aaroexxt/TeensyESC/Pictures/crystals.png

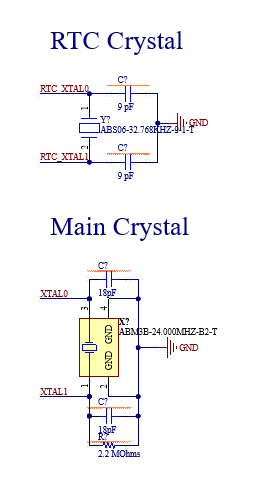
Pictures/crystals.png
