aaroexxt/TeensyESC/Pictures/extio.png

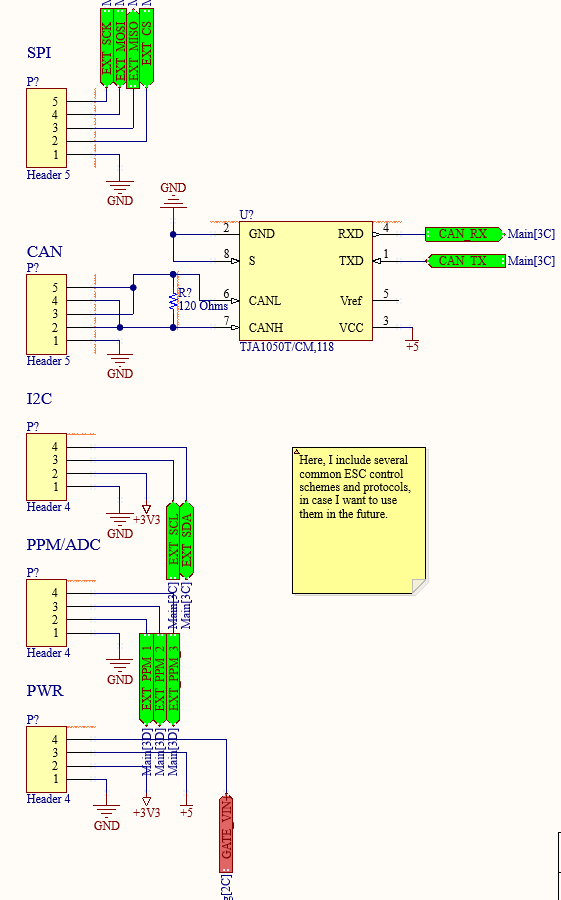
Pictures/extio.png
