aaroexxt/TeensyESC/Pictures/fets.png

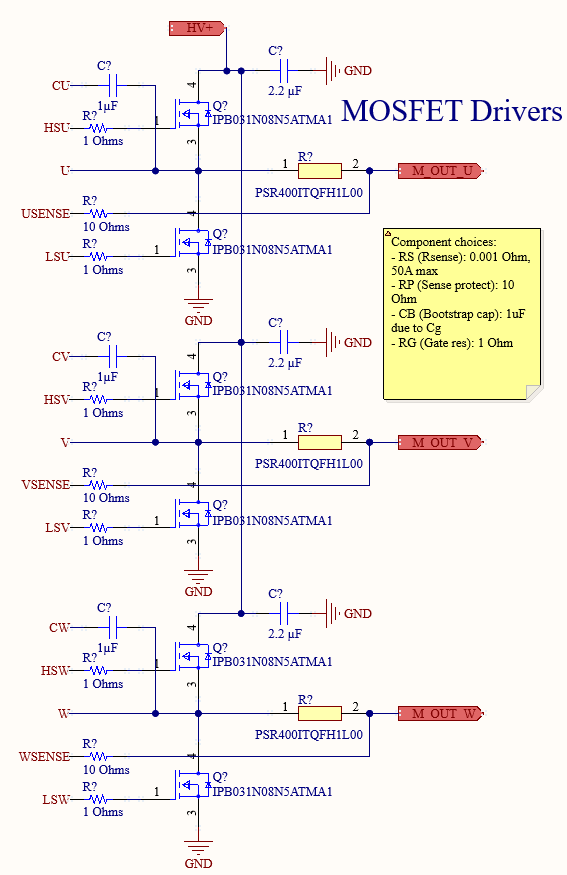
Pictures/fets.png
