aaroexxt/TeensyESC/Pictures/flashmem.png

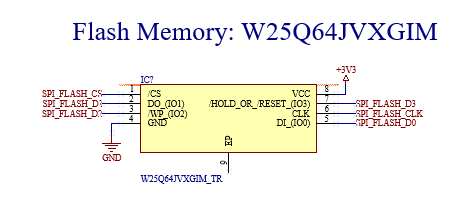
Pictures/flashmem.png
