aaroexxt/TeensyESC/Pictures/mouts.png

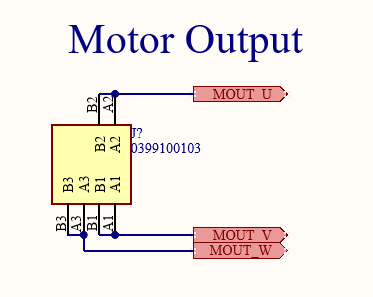
Pictures/mouts.png
