aaroexxt/TeensyESC/Pictures/sresistors.png

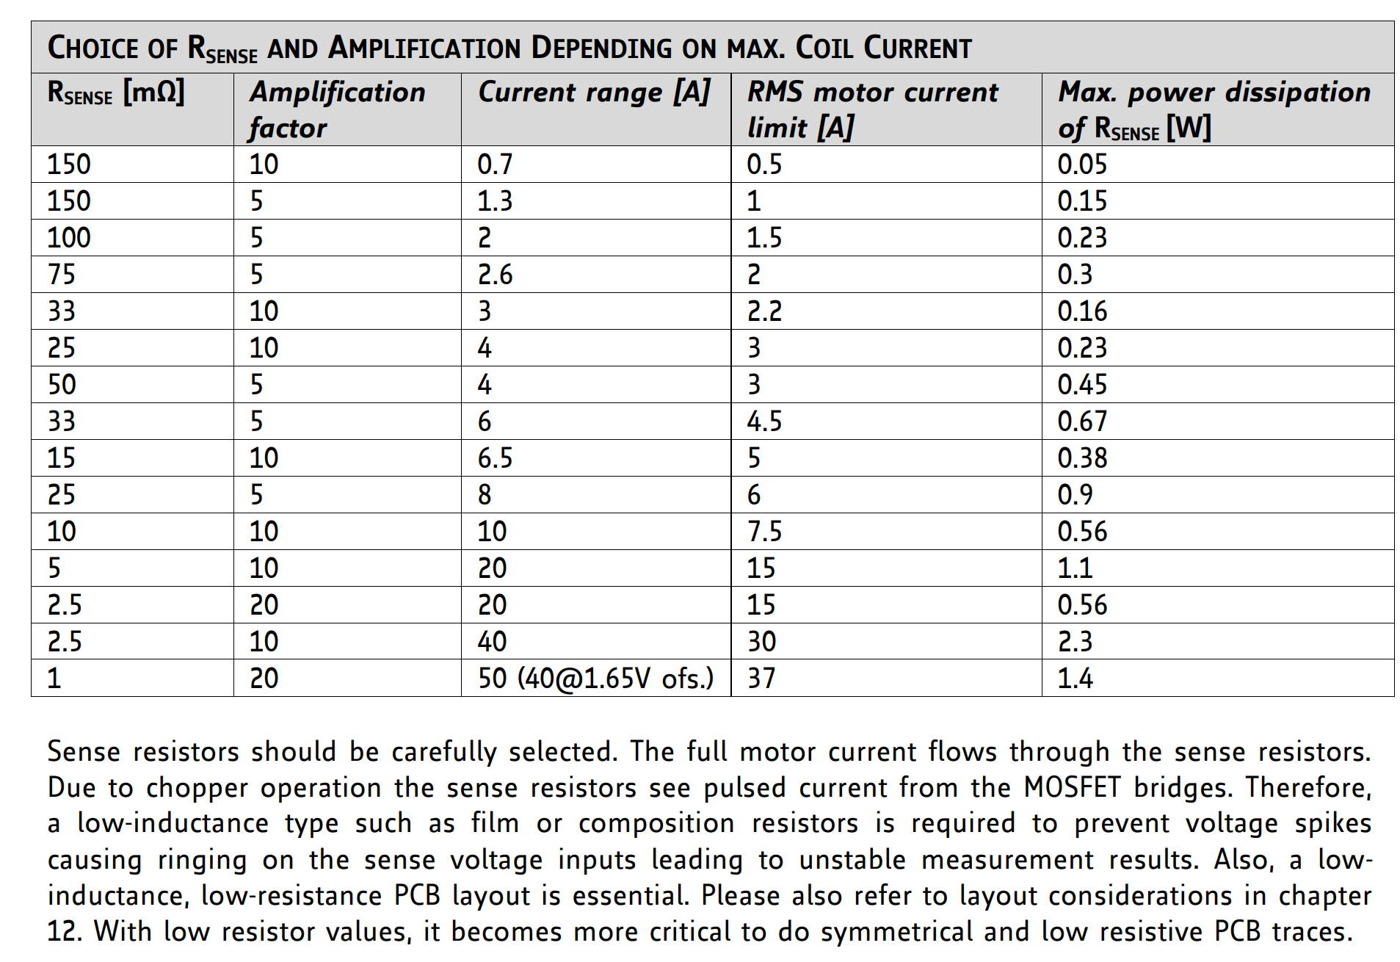
Pictures/sresistors.png
