aaroexxt/TeensyESC/Pictures/tms6200.png

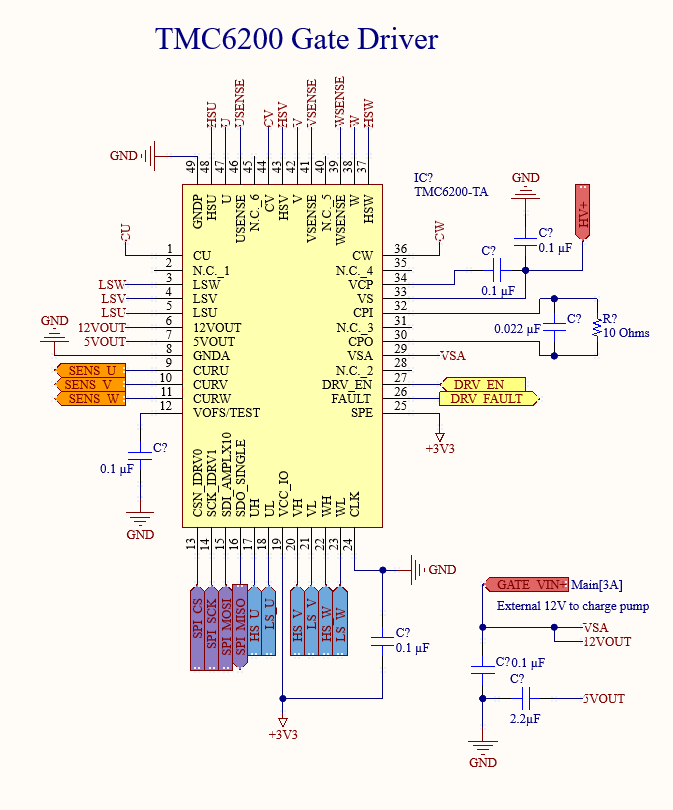
Pictures/tms6200.png
