aaroexxt/TeensyESC/Pictures/usbcin.png

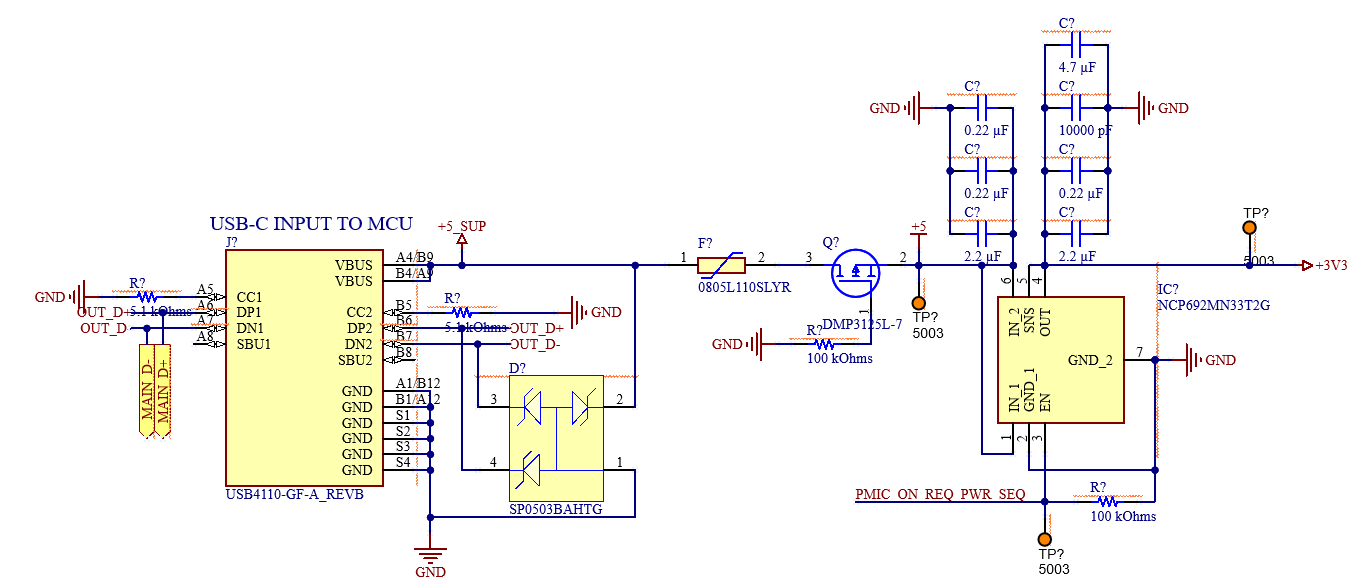
Pictures/usbcin.png
