aaroexxt/TeensyESC/Pictures/usbcout.png

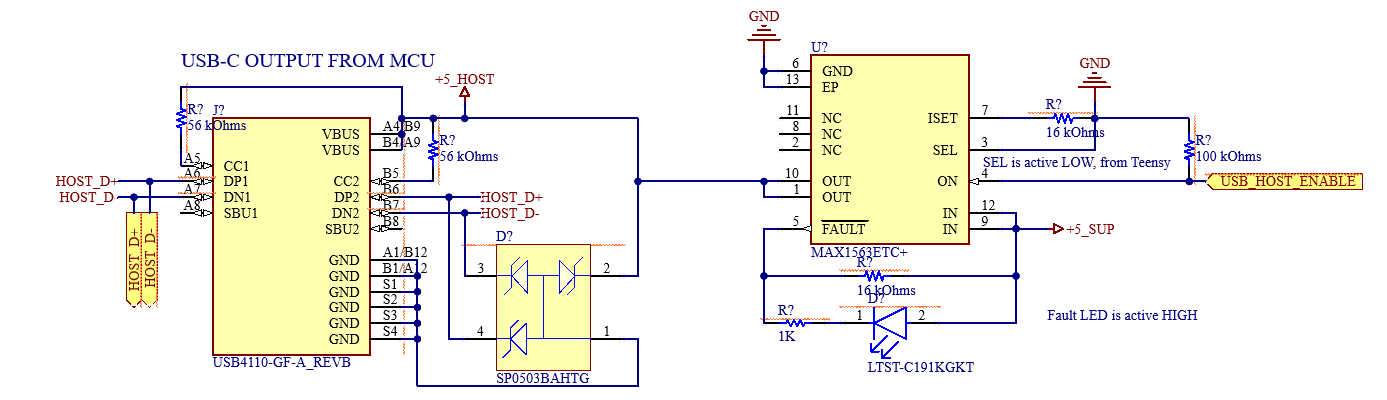
Pictures/usbcout.png
