aaroexxt/TeensyESC/Reference/parts_placement_teensy41_bottom.png

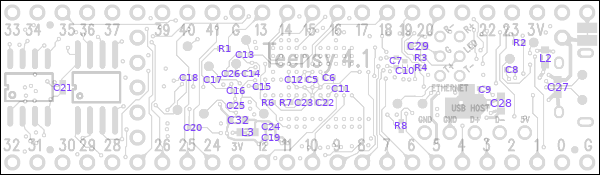
Reference/parts_placement_teensy41_bottom.png
