aaroexxt/TeensyESC/TeensyESCV1.pdf

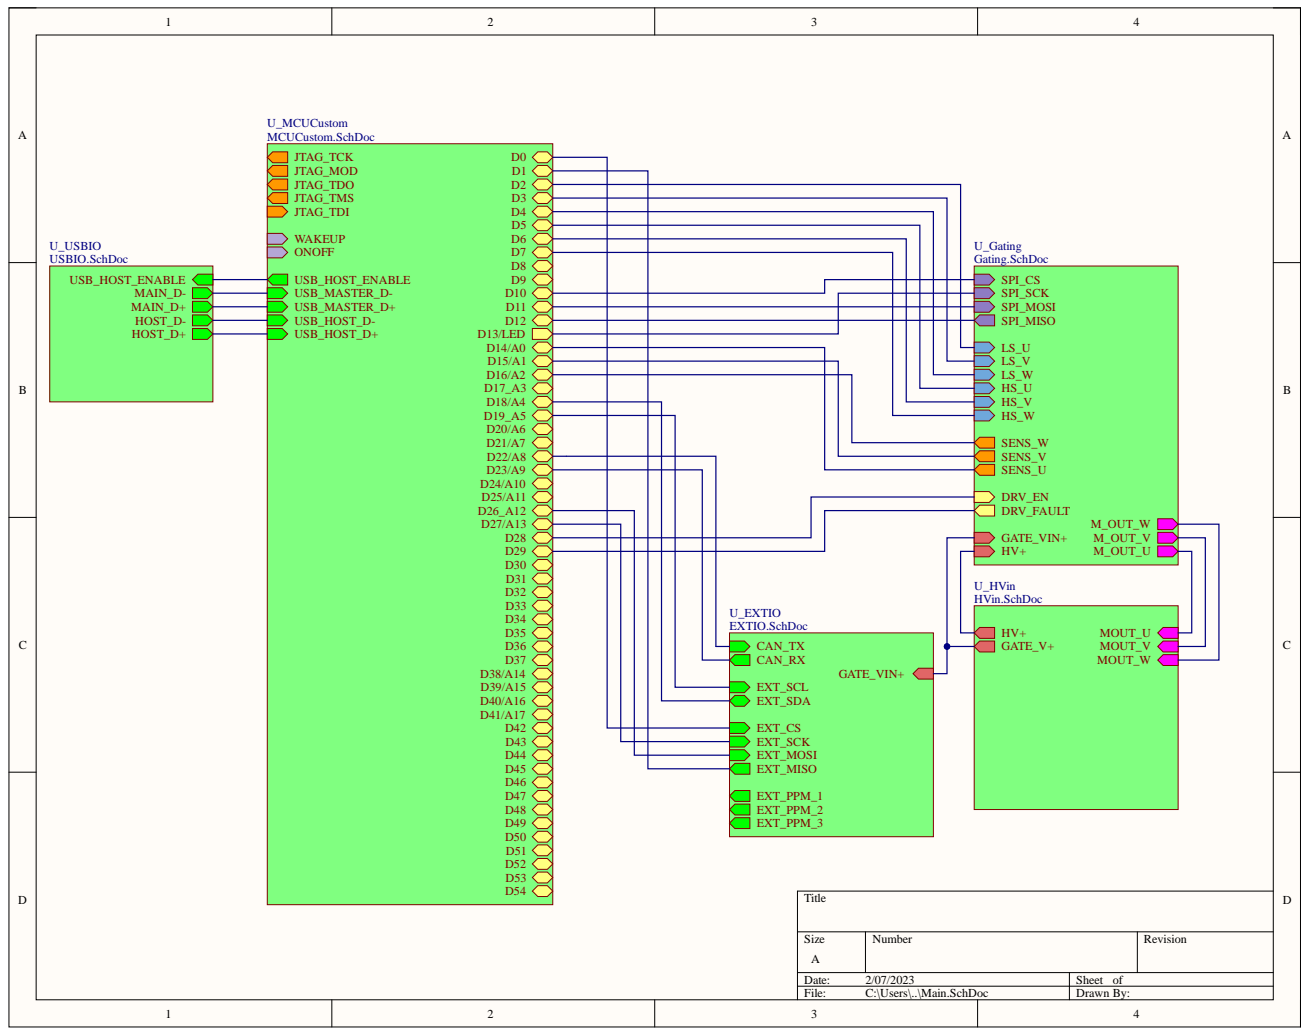
[picture p29: page 1]

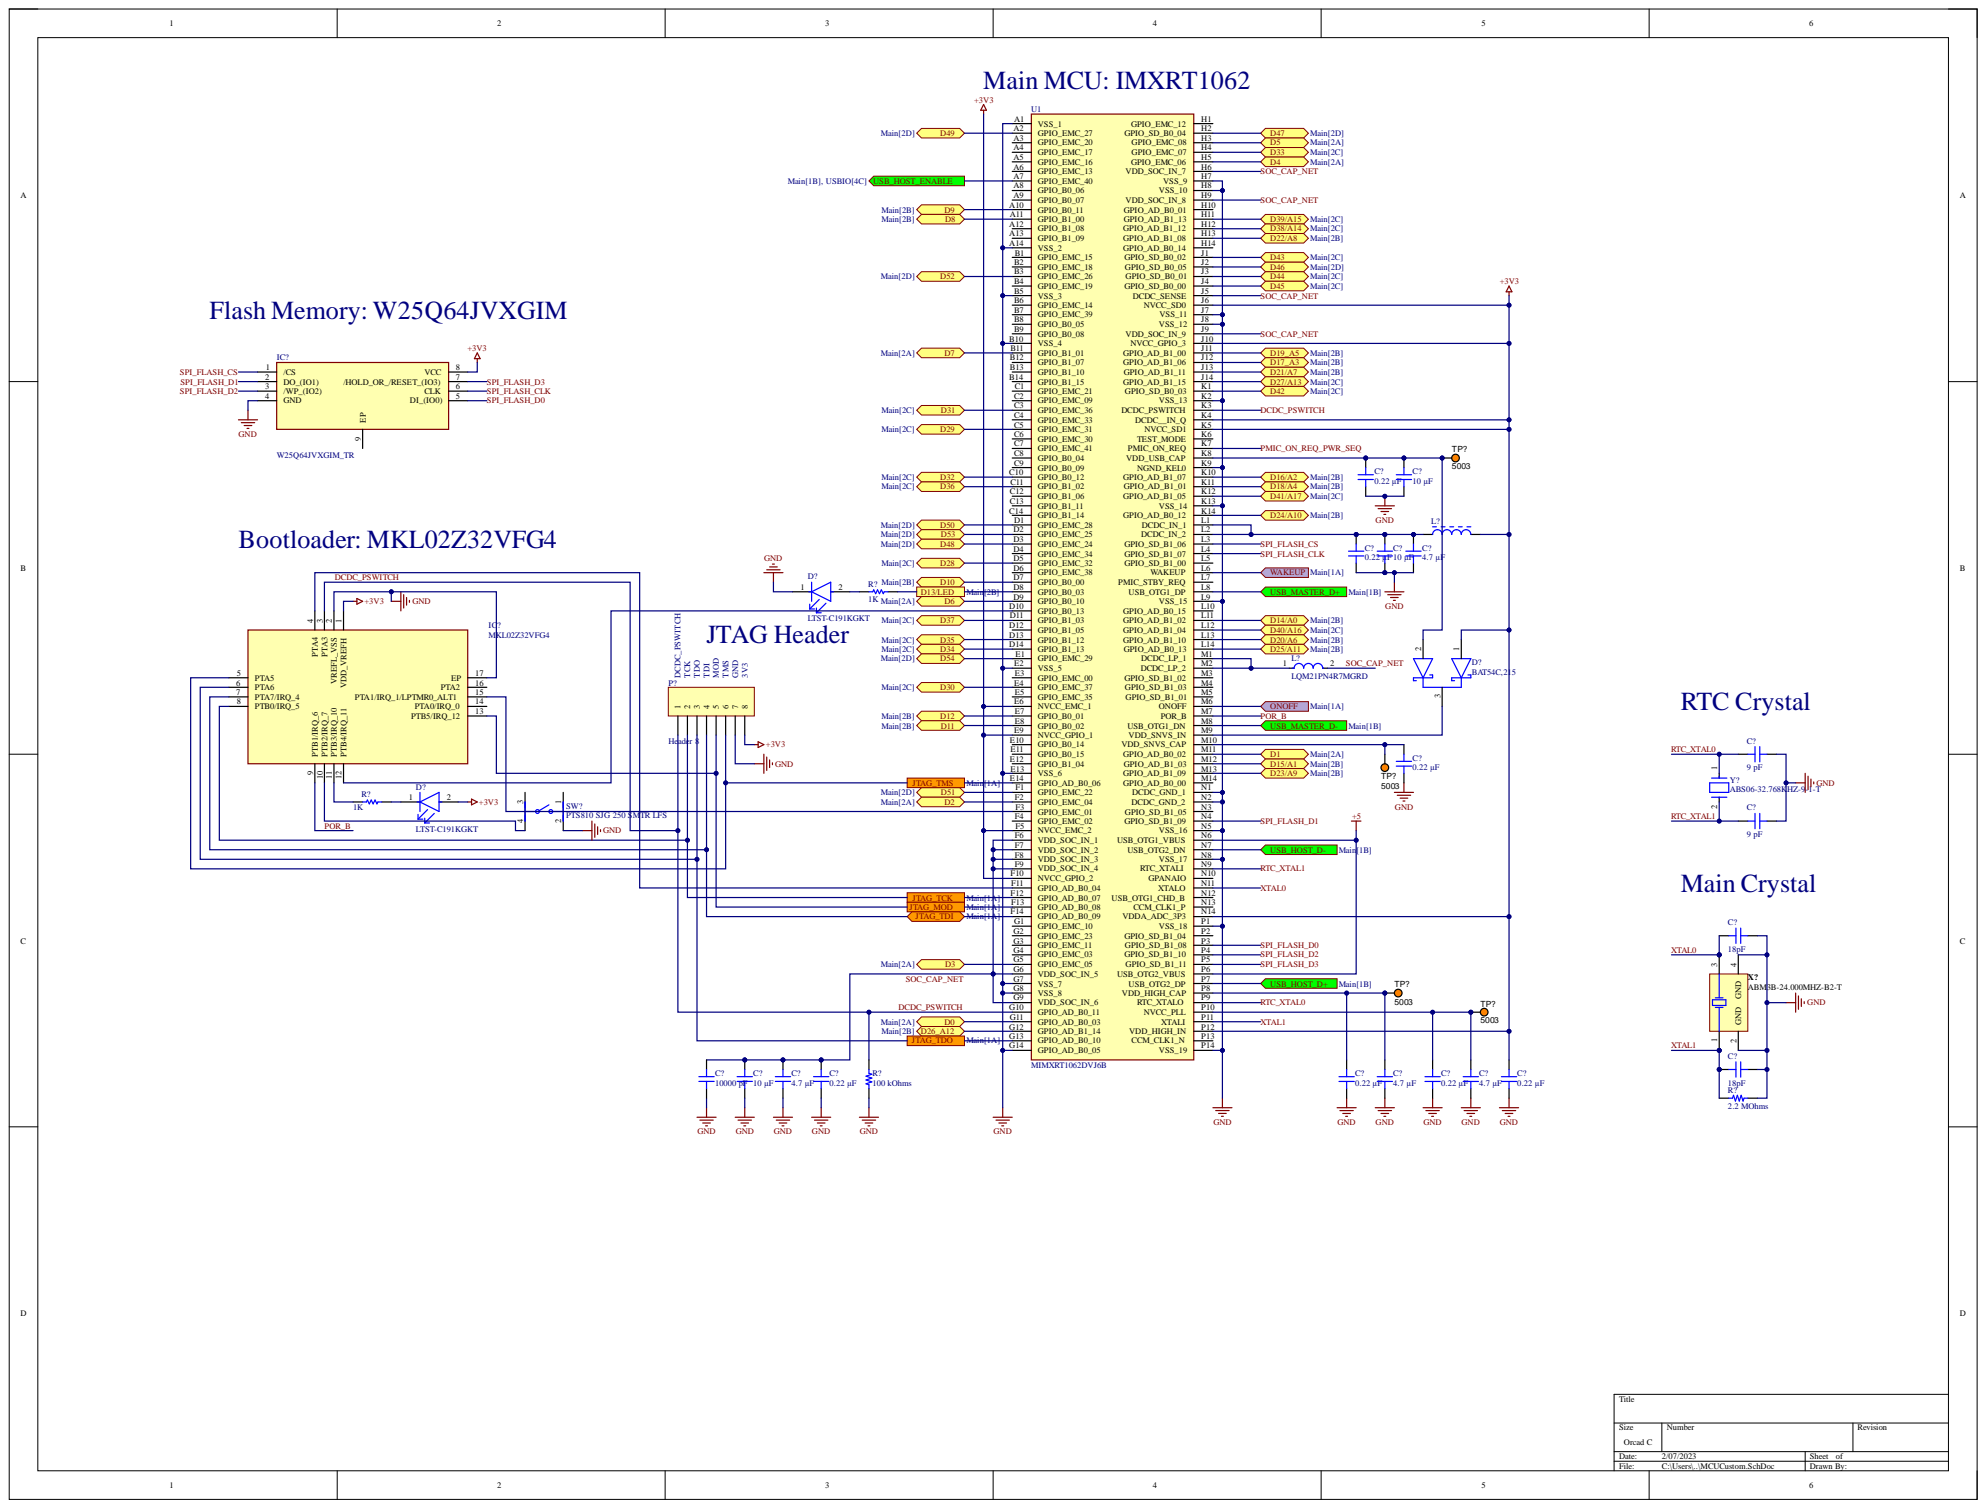
[picture p30: page 2]

DCDC_P S W I T C H | | ]

+3V3 | GND

I | C ? | T-C191KGKT JTAG Header | L 1 1 L12 L13 L14 M 1 M 2 M 3

F 6
F 7 | | US B_HOS T_D-M ain[1B RT C_XTAL 1 XTAL 0

VDD_SOC_IN_6 G9 | P 9 P10 | RT C_XTAL 0

M | | P 1 P12 | 1 XTAL 1

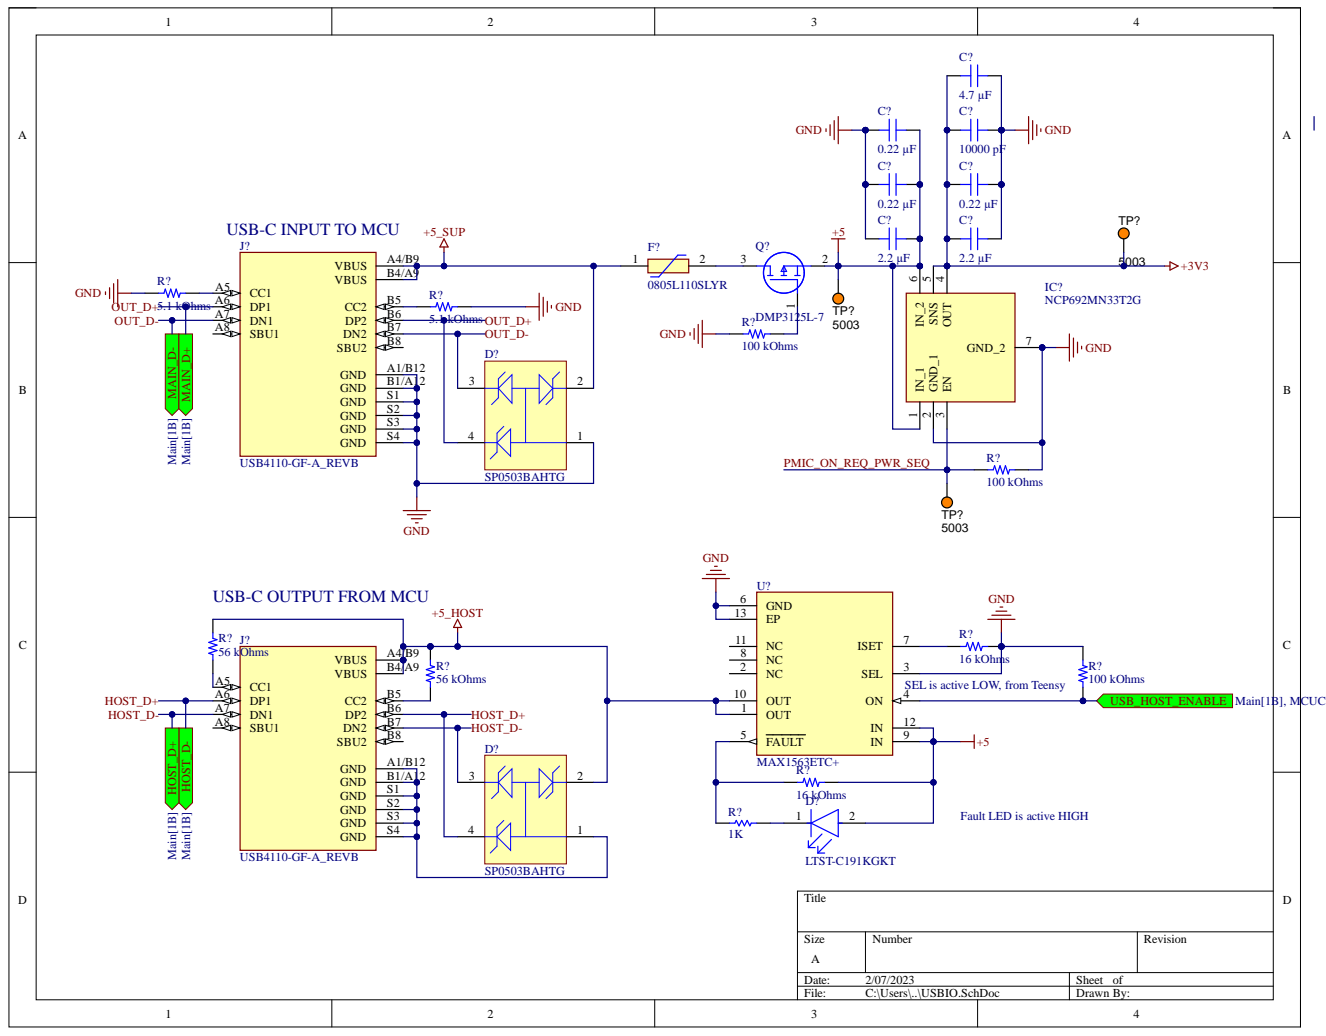
[picture p31: page 3]

USB-C INPUT TO MCU

USB-C OUTPUT FROM MCU

SEL is active LOW, from Teensy

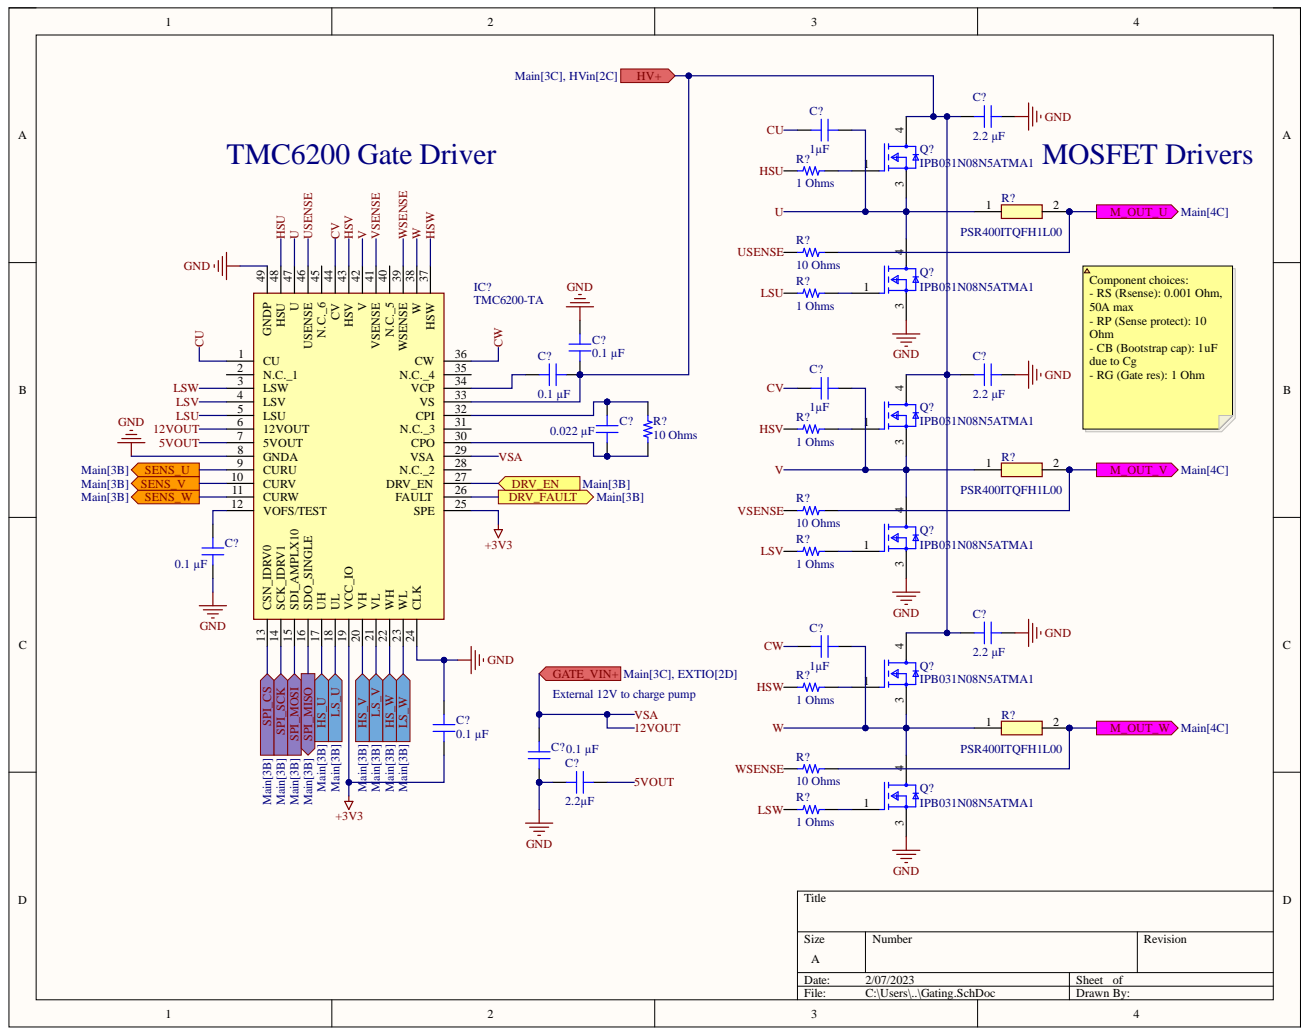
[picture p32: page 4]

Component choices:
- RS (Rsense): 0.001 Ohm,
50A max
- RP (Sense protect): 10
Ohm
- CB (Bootstrap cap): 1uF
due to Cg
- RG (Gate res): 1 Ohm

GATE_VIN+ Main[3C], EXTIO[2D]
External 12V to charge pump

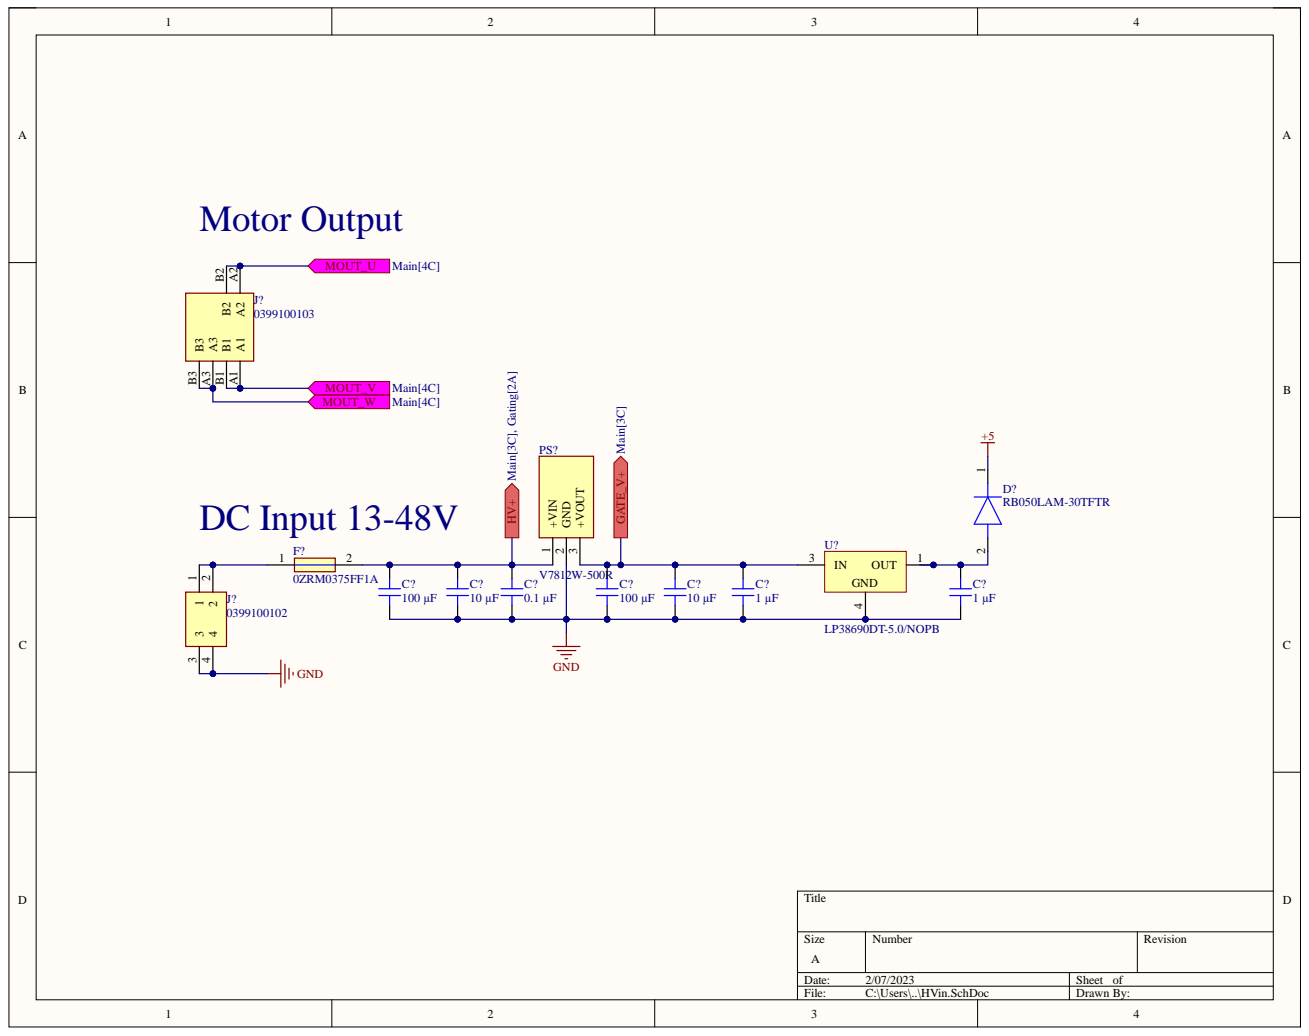
[picture p33: page 5]

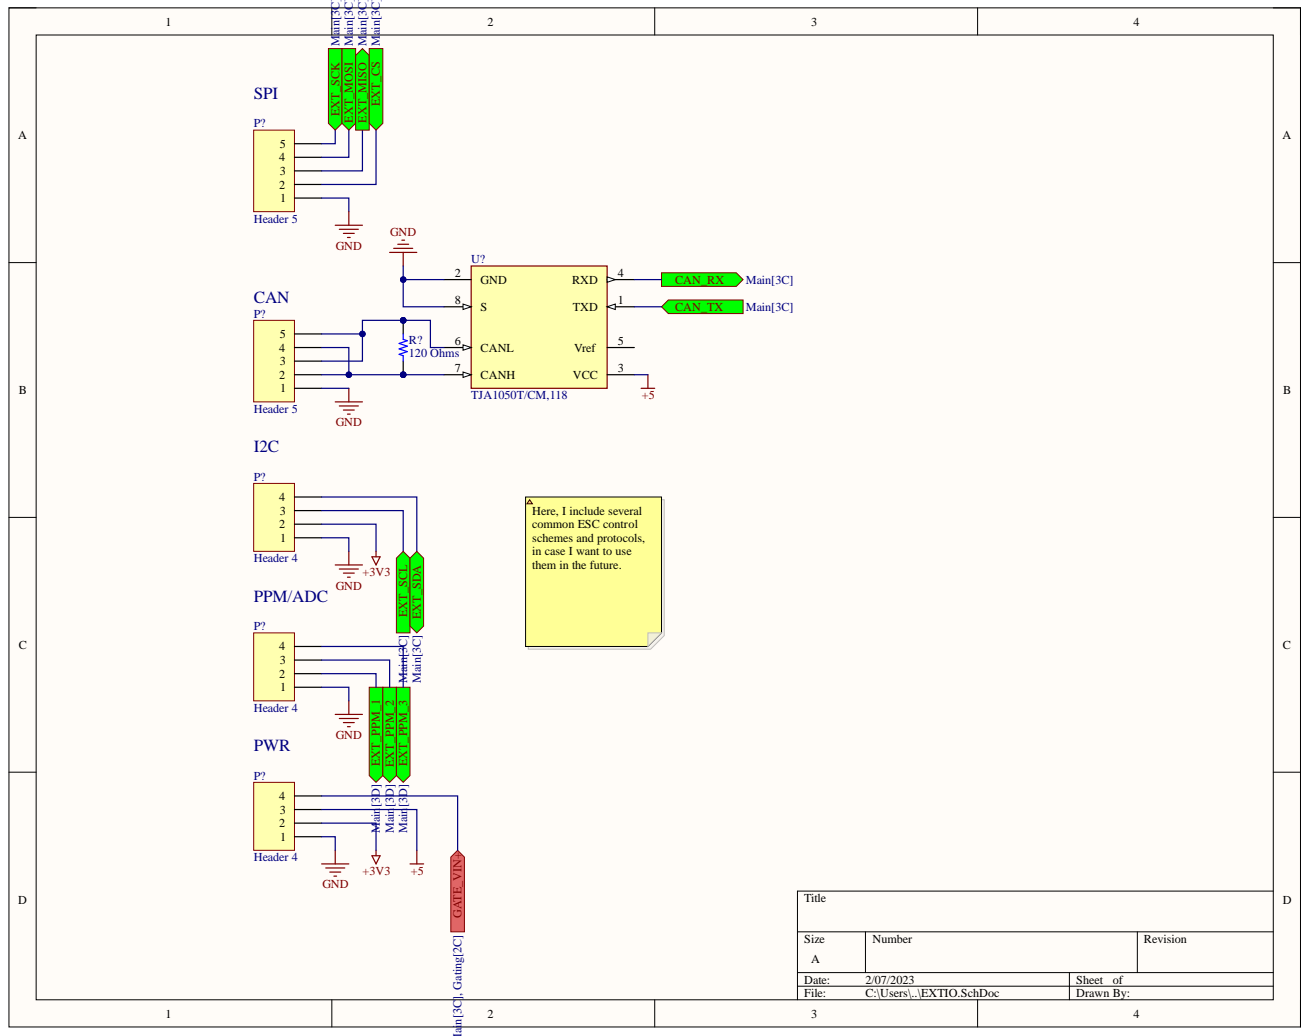
[picture p34: page 6]

CANL 6

120 Ohms

Here, I include several
common ESC control
schemes and protocols,
in case I want to use
them in the future.
