aaroexxt/TeensyESC/(list of files, drawings)

Other design files:
EXTIO.SchDoc
Gating.SchDoc
HVin.SchDoc
Main.SchDoc
MCUCustom.SchDoc
MotorControl.PrjPcb
TeensyESC.PcbDoc
USBIO.SchDoc
