aaroexxt/TeensyESC/(commit log)

2023-01-20 Initial files
    [MCUCustom.SchDoc, Main.SchDoc, MotorControl.PrjPcb, USBIO.SchDoc]
2023-02-07 Lots of progress!! we speeeeed
    [Gating.SchDoc, HVin.SchDoc, MCUCustom.SchDoc, Main.SchDoc, MotorControl.PrjPcb, USBIO.SchDoc]
2023-02-07 Done with PCB
    [IMXRT1062.SchDoc, MCUCustom.SchDoc, Main.SchDoc]
2023-02-07 Exported schematic
    [Gating.SchDoc, TeensyESC.PcbDoc]
2023-02-07 Final changes
    [MotorControl.PrjPcb]
